petrdoubek/waterbag-control/docs/images/screenshot-pdou-voda.herokuapp.com-2022.11.27-18_42_18.png

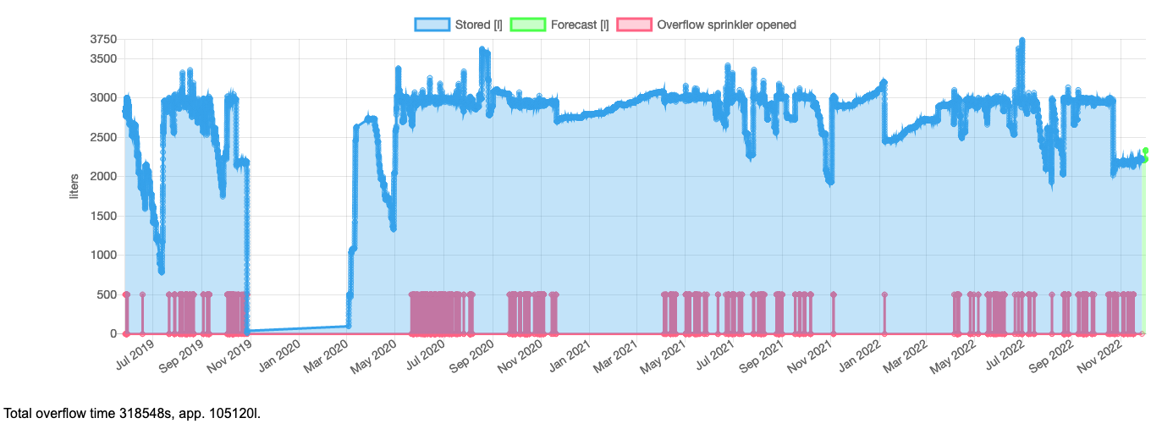
docs/images/screenshot-pdou-voda.herokuapp.com-2022.11.27-18_42_18.png
