petrdoubek/waterbag-control/(threads)

Thread 4 (2019-06-26):

deep sleep for environment sensor

petrdoubek, 2019-06-26:
Environment sensor might run in the garden on battery. [Deep sleep](https://www.losant.com/blog/making-the-esp8266-low-powered-with-deep-sleep) could significantly reduce the power consumption. I found two issues in initial test:

1. According to the link above D0 pin should be connected to RST pin. However when I connect them then upload of sketch from Arduino IDE fails. I tried to connect only after the sketch is uploaded, that seems to work.
1. Deep sleep restarts the sketch, so anything that should be persisted between measurements needs to be stored in EEPROM. But do we really need to persists? In the end it might be enough to wake up every one or two hours, run series of N measurements with few seconds in between, send result (no matter if it changed since the last transmission or not), download new config (if any) and go to sleep.

Thread 5 (2019-07-16):

Instability of ultrasound sensor

petrdoubek, 2019-07-16:
Occasionally my SR04 sensor measures with big error (e.g. 150mm) for a period of time (e.g. 2 hours). Every 5s I'm measuring median from 25 pings and the median is further filtered by median filter with window length 30, i.e. 25*30=600 measurements taken over 5*30=150s are used, yet the measured distance is 130-170mm shorter. I have not seen the opposite error, i.e. longer measurement. I noticed it happens more often when the water level is low, i.e. distance is longer.

I shortened the distance by placing the sensor on a shoe box, which reduced the occurrences, but did not eliminate them completely.

I cannot filter more as I need to open the overflow sprinkler in relatively short time when the bag is full - better waste some water then let the bag burst.

I could detect abrupt change in height, in my case the level cannot change by 150mm in 60s given the diameter of inflow tube, but it can change by that much in 600s. I would have to invalidate measurements for 2 hours, based on one abrupt change, but what if the water really starts flowing in during that time? Not a good option.

Finally, I could place additional sensor(s) at different spot(s), I would need at least 3 total (with 2 I could not decide which is right), but won't they interfere?
