petrdoubek/waterbag-control/(commit log)

2019-05-20 height calculated by arduino, chart changes
2019-05-21 adding arduino code
2019-06-04 print sensor parameters
2019-06-11 fixed storing config to eeprom, added 0 distance check
    [waterbag.ino]
2019-06-12 adding table to measure air temperature and humidity
2019-06-12 removing median filter window from configuration
2019-06-13 moving common arduino functions to a library
2019-06-13 moved also arduino config to library
2019-06-14 renamed LED to LED_PIN
2019-06-14 returning back to old headers until problem is found
    [waterbag.ino]
2019-06-14 switched to new display class
2019-06-14 fixed disp call from wifi, comments
    [waterbag.ino]
2019-06-14 fixed wifi class, switching back to library
    [waterbag.ino]
2019-06-14 measuring temperature and humidity
2019-06-17 adding air sensor, fixes (#1)
    * measuring temperature and humidity
    * fixed forecast update
    * reset timeouts after reading new config
    * changing air sensor config
    [air.ino, waterbag.ino]
2019-06-22 environment sensor
    * adding moisture sensor to air
    * fixed url param
    * using 3 tables for environment
    * renaming
    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
    [air.ino]
2019-06-22 fixed moisture insert
2019-06-25 chart for temperature, humidity, moisture
2020-05-30 new controller for drying fan - wip (#6)
    * some changes
    * controller for drying fan - wip
    * nicer log
    * absolute humidity formula - test it
    * measuring from two sensors, not reliable - wip
    * new table for drying fan
2020-06-03 reset medial filter after each loop - do not send old median if nothing was measured in the loop
    [dryingfan.ino]
2020-07-30 drying fan wip
